cantalouperadio/cantalouperadio/README.md

# Cantaloupe Radio Factory Radio Retrofit Platform

This project contains integrated hardware and firmware to allow stealthy, tight integrations of modern audio technology into factory classic car radios.

TODO lots more to write and explain...
