cantalouperadio/cantalouperadio/hardware/mdeckprogrammer/MDeckProgrammer.brd

## EAGLE design hardware/mdeckprogrammer/MDeckProgrammer.brd (2020-07-01)

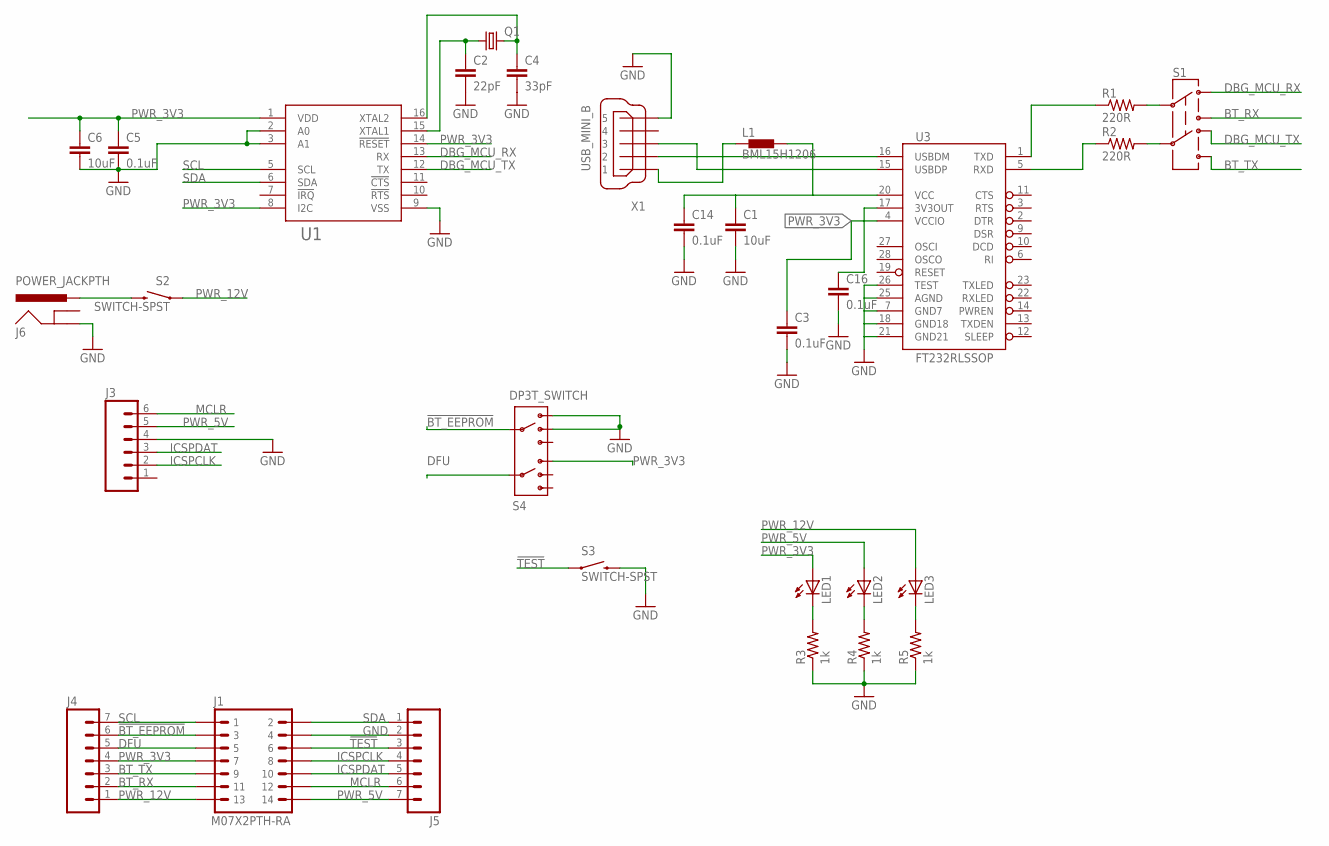
[picture p2: schematic MDeckProgrammer.sch]

Parts:
C1, C6: 10uF; 1206
C2: 22pF; 1206
C3, C5, C14, C16: 0.1uF; 1206
C4: 33pF; 1206
J1: M07X2PTH-RA; JST-14-PUD-PTH
J3: M06HARWIN_RA; 1X06_RA
J4, J5: M07; 1X07
J6: POWER_JACKPTH; POWER_JACK_PTH
L1: BML15H1206; 1206
LED1, LED2, LED3: LEDCHIPLED_1206; CHIPLED_1206
Q1: CRYSTALHC49S; HC49/S
R1, R2: 220R; 1206
R3, R4, R5: 1k; 1206
S1: SWITCH-DPDTPTH; MSS22
S2, S3: SWITCH-SPST; GF-123-0054
S4: DP3T_SWITCH; EG2301A
U1: SC16IS740TSSOP16; TSSOP16
U3: FT232RLSSOP; SSOP28DB
X1: USB_MINI_B; USB_MINI_B_PTH

Connections:
!BT_EEPROM: J1.P$3 (3), J4.6, S4.P$3 (COMA)
!TEST: J1.P$6 (6), J5.3, S3.P$1 (1)
BT_RX: J1.P$11 (11), J4.2, S1.3
BT_TX: J1.P$9 (9), J4.3, S1.6
DBG_MCU_RX: S1.1, U1.13 (RX)
DBG_MCU_TX: S1.4, U1.12 (TX)
DFU: J1.P$5 (5), J4.5, S4.P$7 (COMB)
GND: C1.2, C2.2, C3.2, C4.2, C5.2, C6.2, C14.2, C16.2, J1.P$4 (4), J3.4, J5.2, J6.GND, R3.1, R4.1, R5.1, S3.P$2 (2), S4.P$1 (A1), S4.P$2 (A2), U1.2 (A0), U1.3 (A1), U1.9 (VSS), U3.7 (GND7), U3.18 (GND18), U3.21 (GND21), U3.25 (AGND), U3.26 (TEST), X1.5
ICSPCLK: J1.P$8 (8), J3.2, J5.4
ICSPDAT: J1.P$10 (10), J3.3, J5.5
MCLR: J1.P$12 (12), J3.6, J5.6
unnamed: R1.2, S1.2
unnamed: R2.2, S1.5
unnamed: C2.1, Q1.1, U1.15 (XTAL1)
unnamed: C4.1, Q1.2, U1.16 (XTAL2)
unnamed: J6.PWR, S2.P$2 (2)
unnamed: R1.1, U3.1 (TXD)
unnamed: R2.1, U3.5 (RXD)
unnamed: U3.15 (USBDP), X1.3
unnamed: U3.16 (USBDM), X1.2
unnamed: LED1.C, R3.2
unnamed: L1.1, X1.1
unnamed: C1.1, C14.1, L1.2, U3.20 (VCC)
unnamed: LED2.C, R4.2
unnamed: C16.1, U3.17 (3V3OUT)
unnamed: LED3.C, R5.2
PWR_3V3: C3.1, C5.1, C6.1, J1.P$7 (7), J4.4, LED1.A, S4.P$5 (B1), U1.1 (VDD), U1.8 (I2C), U1.14 (!RESET), U3.4 (VCCIO)
PWR_5V: J1.P$14 (14), J3.5, J5.7, LED2.A
PWR_12V: J1.P$13 (13), J4.1, LED3.A, S2.P$1 (1)
SCL: J1.P$1 (1), J4.7, U1.5 (SCL)
SDA: J1.P$2 (2), J5.1, U1.6 (SDA)

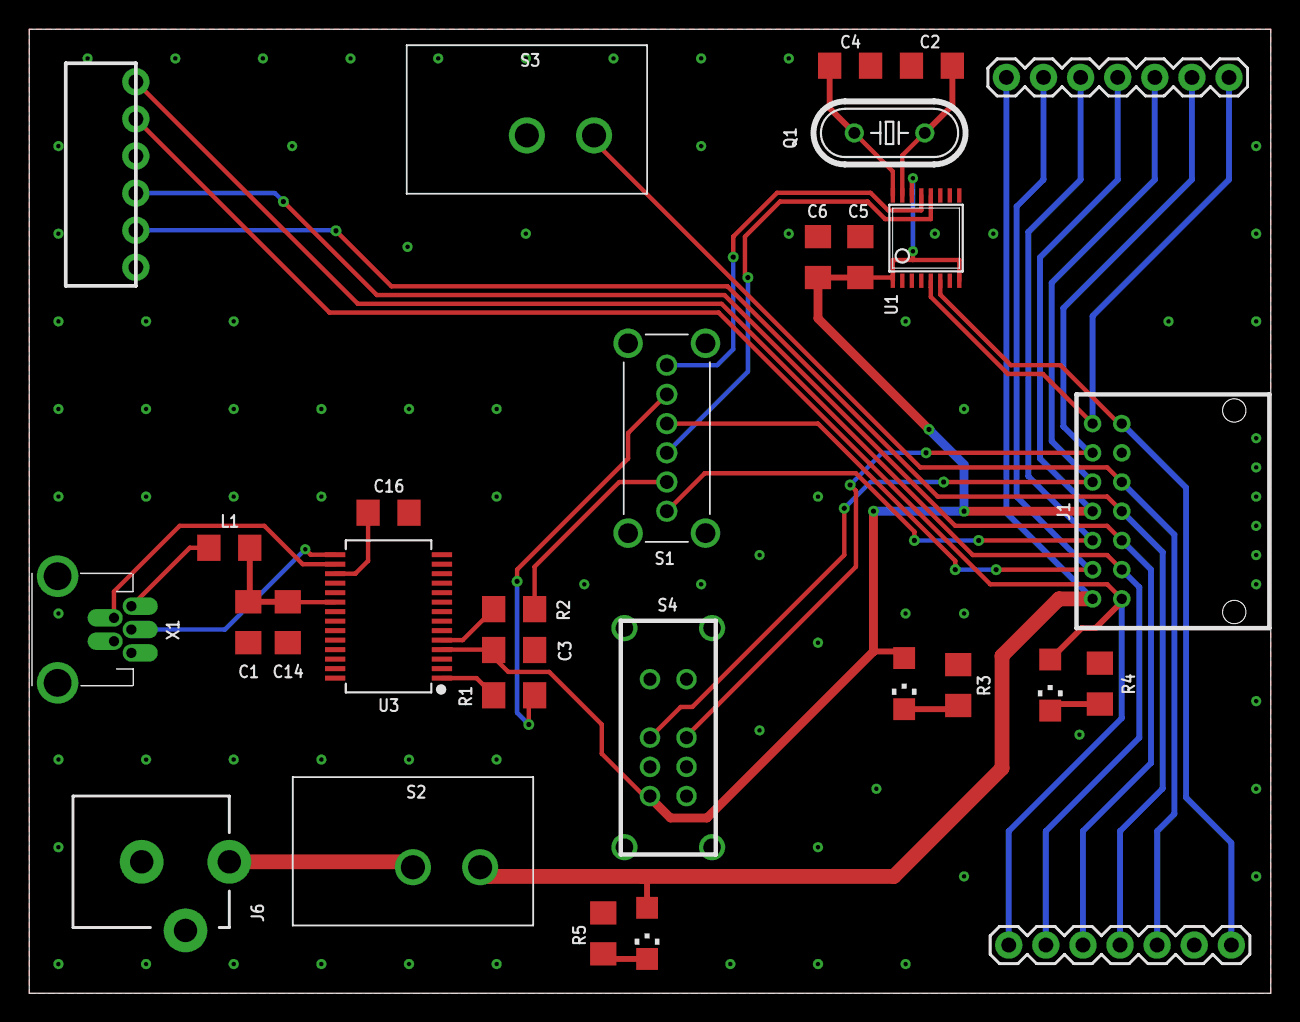
[picture p3: board MDeckProgrammer.brd from above]

Board: 2 copper layers, 85.0 x 66.0 mm, 30 parts (0 on the bottom side), 31 nets.
