cantalouperadio/cantalouperadio/hardware/ba/pogobed/BA2PogoBed.brd

## EAGLE design hardware/ba/pogobed/BA2PogoBed.brd (2020-07-01)

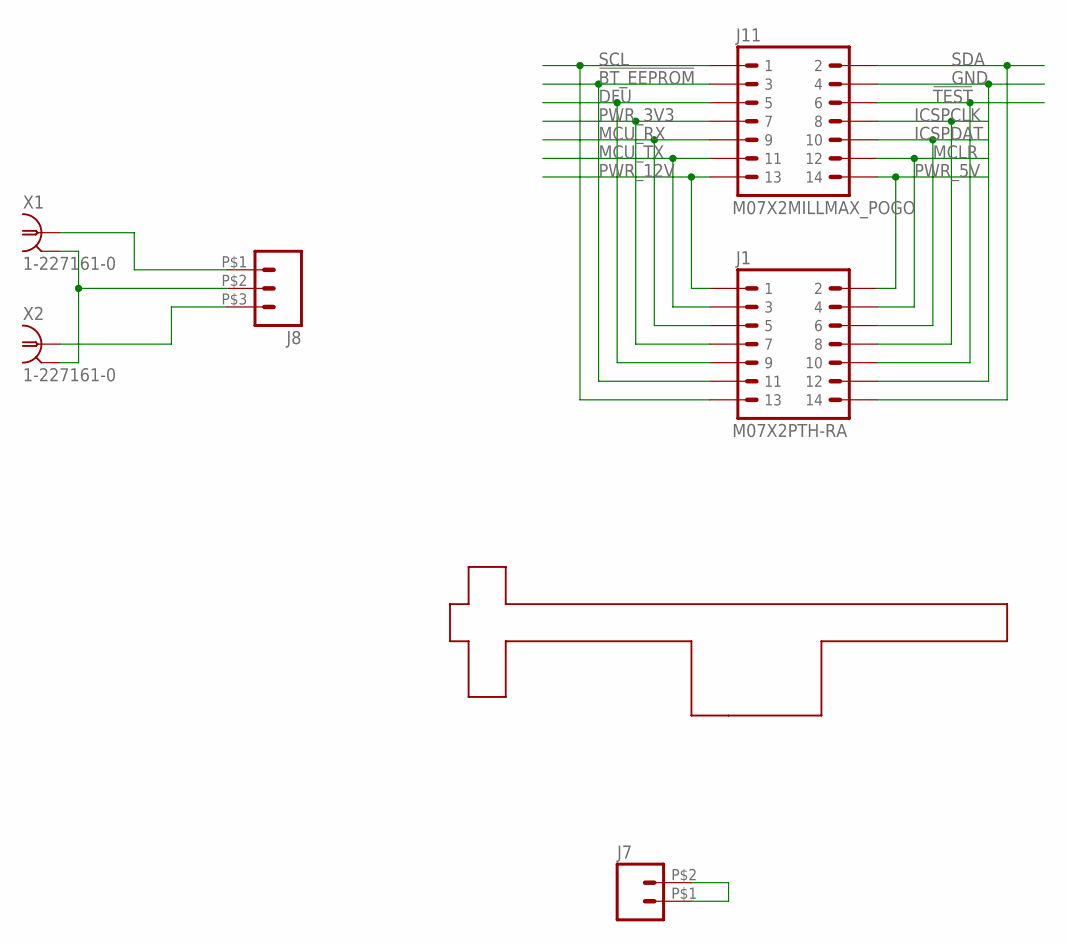
[picture p4: schematic BA2PogoBed.sch, sheet 1]

Parts:
J1: M07X2PTH-RA; JST-14-PUD-PTH
J7: M02; MILLMAX_838_1X2
J8: M03; MILLMAX_836_1X3
J11: M07X2MILLMAX_POGO; MILLMAX_838_7X2
M1: TOGGLE_CLAMP_LARGE
X1, X2: 1-227161-0; AMP_227161

Connections:
!BT_EEPROM: J1.P$11 (11), J11.P$3 (3)
!TEST: J1.P$10 (10), J11.P$6 (6)
DFU: J1.P$9 (9), J11.P$5 (5)
GND: J1.P$12 (12), J11.P$4 (4)
ICSPCLK: J1.P$8 (8), J11.P$8 (8)
ICSPDAT: J1.P$6 (6), J11.P$10 (10)
MCLR: J1.P$4 (4), J11.P$12 (12)
MCU_RX: J1.P$5 (5), J11.P$9 (9)
MCU_TX: J1.P$3 (3), J11.P$11 (11)
unnamed: J7.P$1 (1), J7.P$2 (2)
unnamed: J8.P$2 (2), X1.2, X2.2
unnamed: J8.P$1 (1), X1.1
unnamed: J8.P$3 (3), X2.1
PWR_3V3: J1.P$7 (7), J11.P$7 (7)
PWR_5V: J1.P$2 (2), J11.P$14 (14)
PWR_12V: J1.P$1 (1), J11.P$13 (13)
SCL: J1.P$13 (13), J11.P$1 (1)
SDA: J1.P$14 (14), J11.P$2 (2)

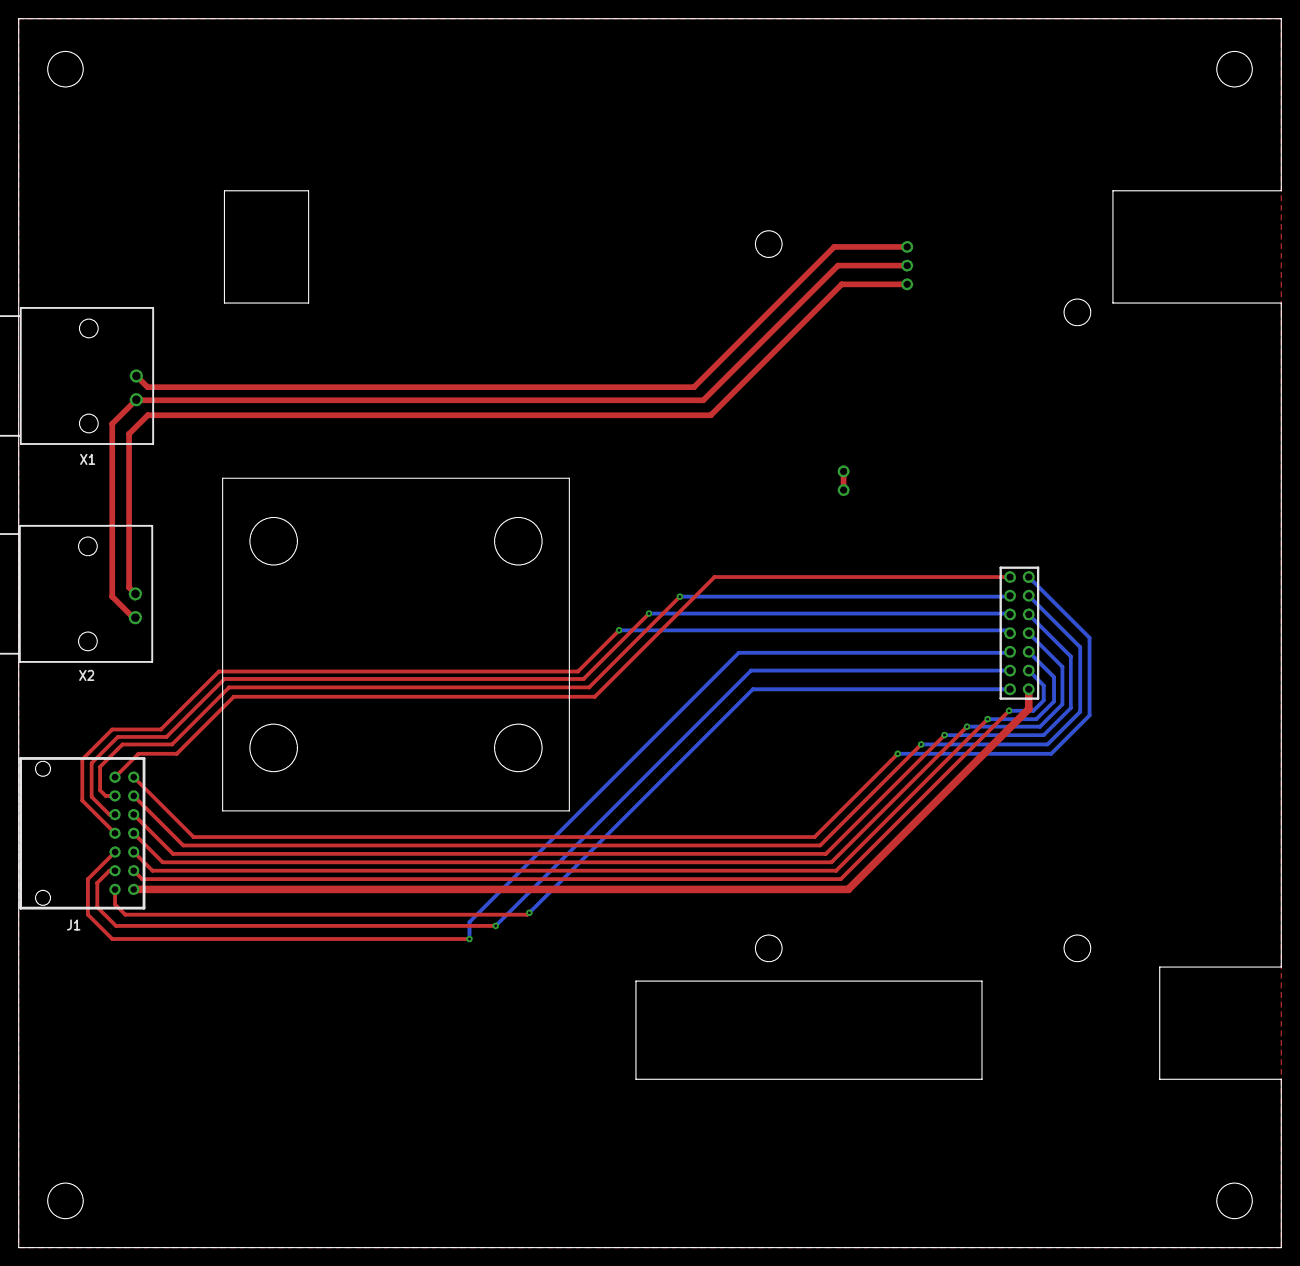
[picture p5: board BA2PogoBed.brd from above]

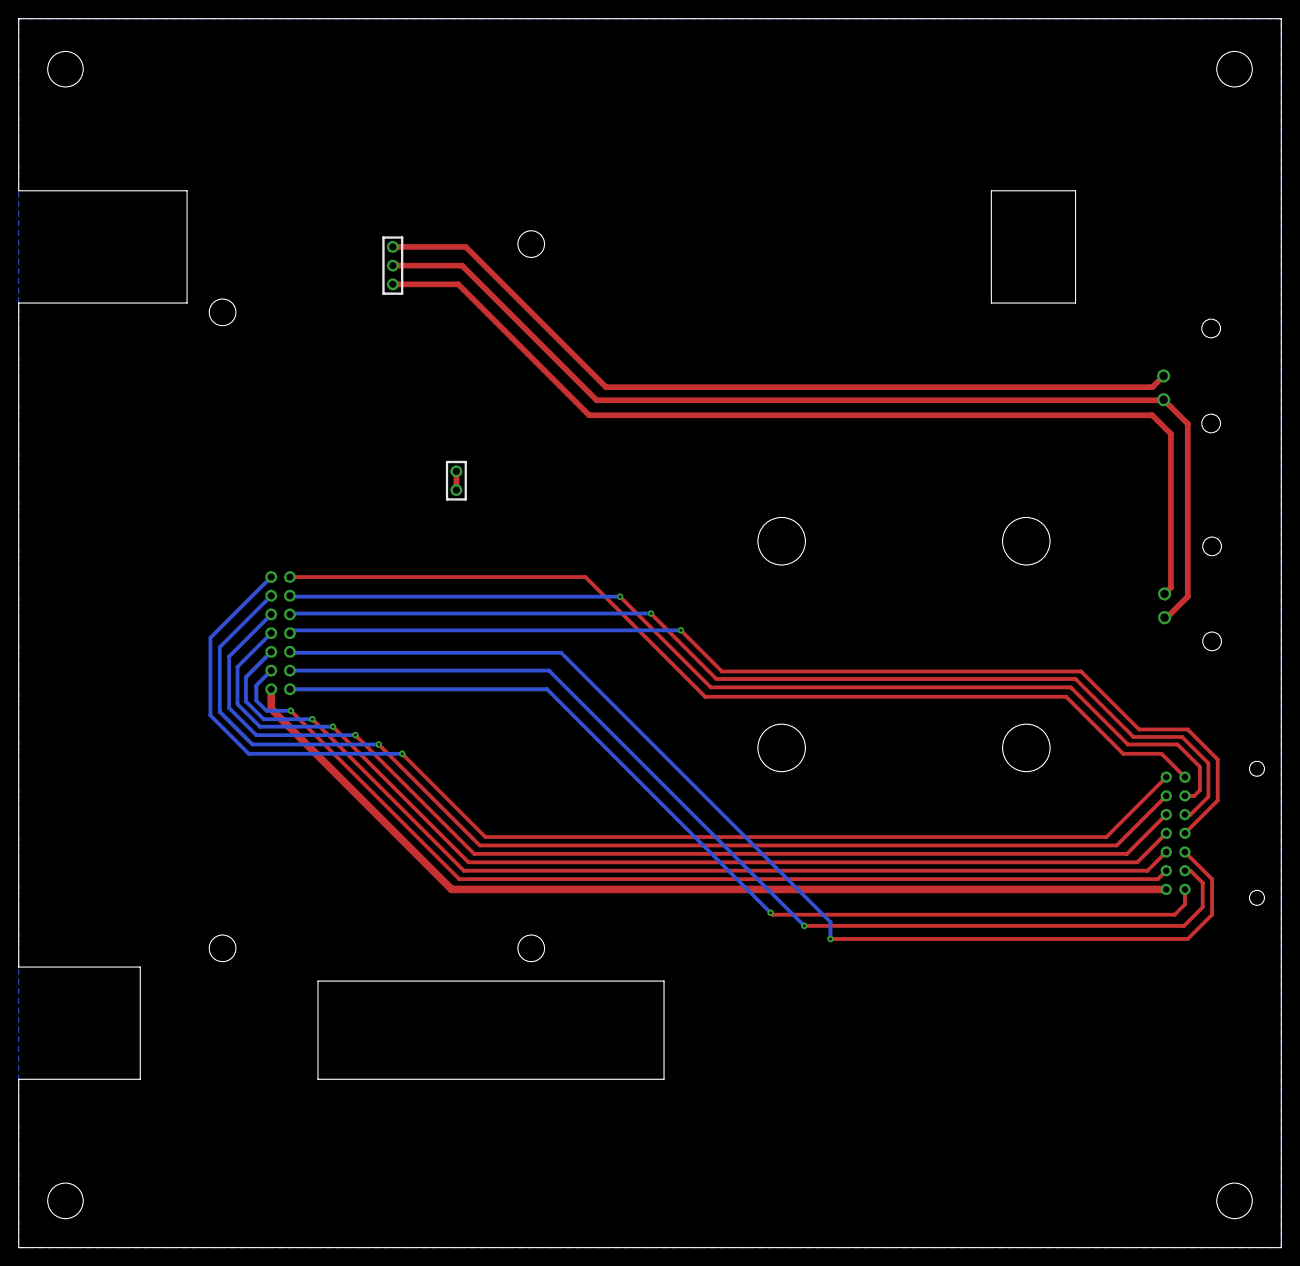
[picture p6: board BA2PogoBed.brd from below]

Board: 2 copper layers, 135.0 x 131.4 mm, 7 parts (2 on the bottom side), 18 nets.
