cantalouperadio/cantalouperadio/hardware/ba/MDeckBA.brd

## EAGLE design hardware/ba/MDeckBA.brd (2020-05-11)

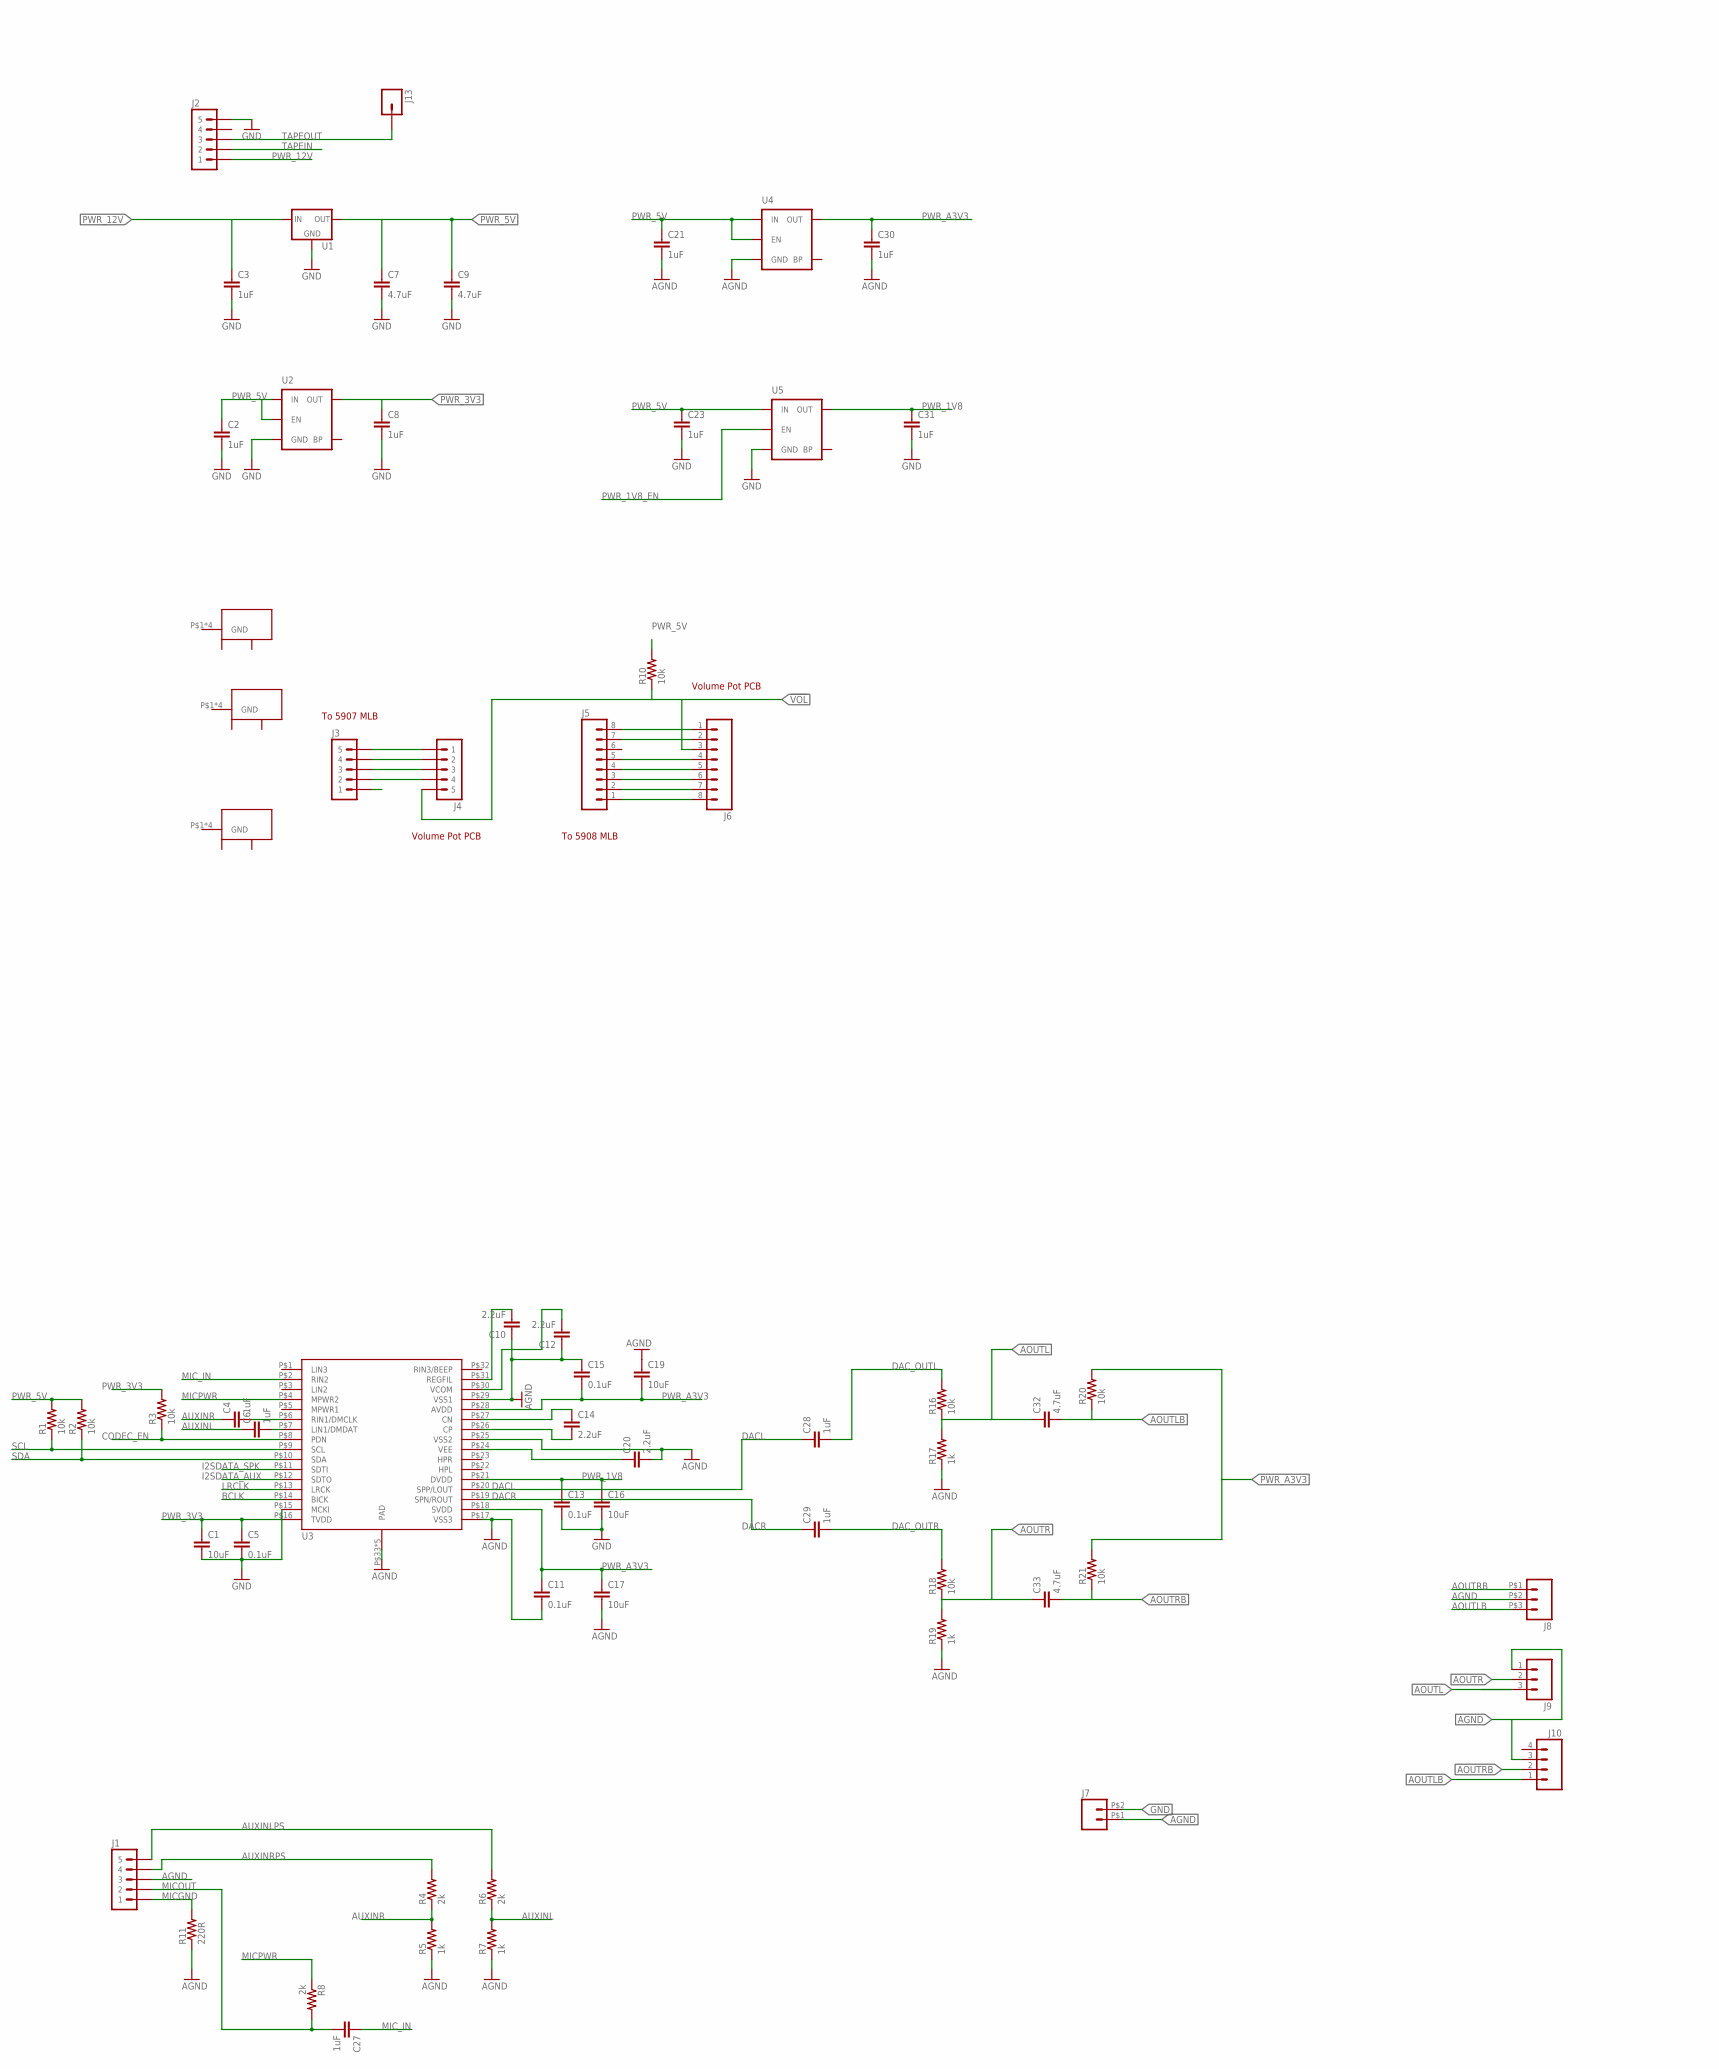
[picture p7: schematic MDeckBA.sch, sheet 1, part in row 1, column 1]

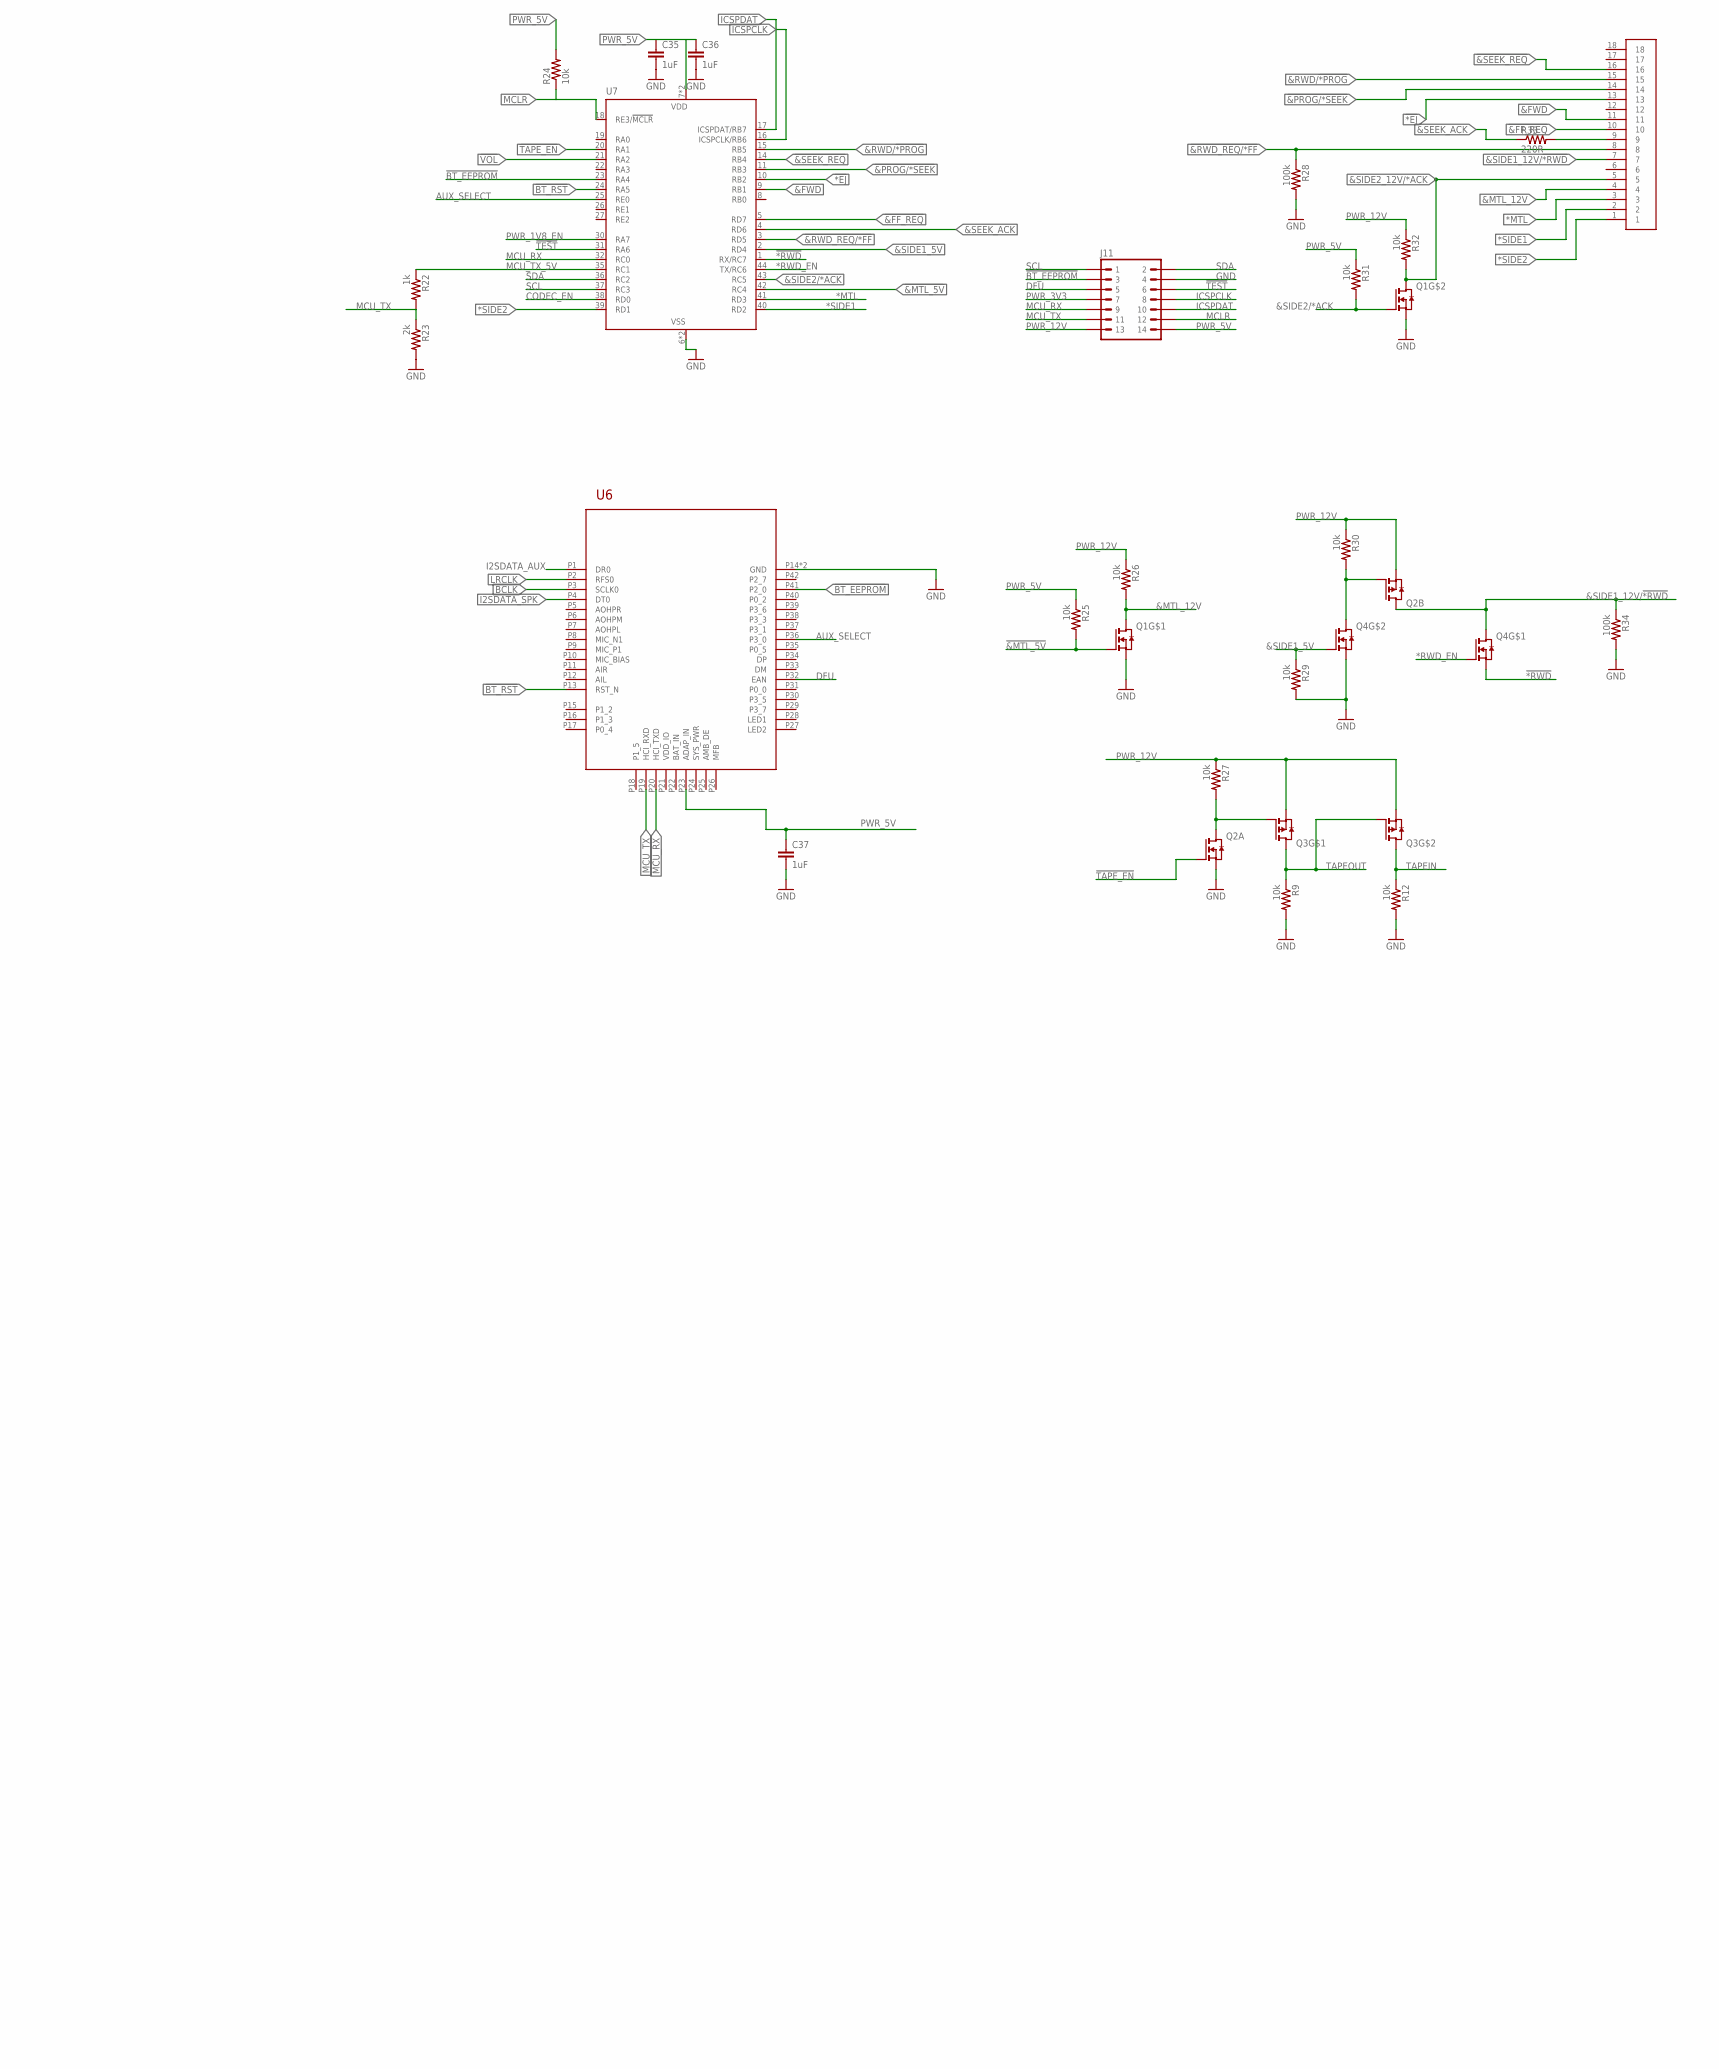
[picture p8: schematic MDeckBA.sch, sheet 1, part in row 1, column 2]

Parts:
C1, C16, C17, C19: 10uF; 0805
C2, C3, C4, C6, C8, C21, C23, C27, C28, C29, C30, C31, C35, C36, C37: 1uF; 0805
C5, C11, C13, C15: 0.1uF; 0805
C7, C9, C32, C33: 4.7uF; 0805
C10, C12, C14, C20: 2.2uF; 0805
J1, J3: M05JST; JST-5-PTH
J2, J4: M05JST-VERT; JST-5-PTH-VERT
J5: JST-PH-8; JST-8-PTH
J6: JST-PH-8-VERT; JST-8-PTH-VERT
J7: M022MM_PADS; 1X02_2MM_PADS
J8: M032MM_PADS; 1X03_2MM_PADS
J9: M03JST-PTH-VERT; JST-3-PTH-VERT
J10: M04JST-PTH-VERT; JST-4-PTH-VERT
J11: M07X2; 2X07_PADS_2MM
J12: MOLEX_0039532184_18_POS_FFC
J13: M01PTH_NO_SILK_YES_STOP; 1X01_NO_SILK
M1, M2, M3: KEYSTONE_7773_SCREW_TERMINAL
Q1, Q4: N_MOSFETSOT-363; SOT363
Q2: PN_MOSFET-FDG6332C_F085SOT363; SOT363
Q3: P_MOSFET_DUAL; SO08
R1, R2, R3, R9, R10, R12, R16, R18, R20, R21, R24, R25, R26, R27, R29, R30, R31, R32: 10k; 0805
R4, R6, R8, R23: 2k; 0805
R5, R7, R17, R19, R22: 1k; 0805
R11: 220R; 2010-RES
R28, R34: 100k; 0805
R33: 220R; 0805
U1: V_REG_SOT223LDL1117; SOT223
U2: V_REG_LDOMIC5317SMD; SOT23-5
U3: AK4951; QFN32_0.4MM
U4: V_REG_LDOLDLN025SMD; SOT23-5
U5: V_REG_LDOMIC5317-1.8SMD; SOT23-5
U6: BM64SMD; BM64
U7: PIC16LF18875PIC16LF18877; TQFP44

Connections:
!&FF_REQ: J12.10, U7.5 (RD7)
!&MTL_5V: Q1.2 (G), R25.2, U7.42 (RC4)
!&PROG/*SEEK: J12.14, U7.11 (RB3)
!&RWD_REQ/*FF: J12.8, R28.1, U7.3 (RD5)
!&SEEK_REQ: J12.16, U7.14 (RB4)
!*EJ: J12.13, U7.10 (RB2)
!*RWD: Q4.1 (S), U7.1 (RX/RC7)
!BT_EEPROM: J11.P$3 (3), U6.P41 (P2_0), U7.23 (RA4)
!BT_RST: U6.P13 (RST_N), U7.24 (RA5)
!TAPE_EN: Q2.2 (G), U7.20 (RA1)
!TEST: J11.P$6 (6), U7.31 (RA6)
!VOL: J4.5, J6.3, R10.1, U7.21 (RA2)
&FWD: J12.11, U7.9 (RB1)
&MTL_12V: J12.4, Q1.6 (D), R26.2
&RWD/!*PROG: J12.15, U7.15 (RB5)
&SEEK_ACK: R33.1, U7.4 (RD6)
&SIDE1_5V: Q4.5 (G), R29.1, U7.2 (RD4)
&SIDE1_12V/!*RWD: J12.7, Q2.3 (D), Q4.6 (D), R34.1
&SIDE2/*ACK: Q1.5 (G), R31.2, U7.43 (RC5)
&SIDE2_12V/*ACK: J12.5, Q1.3 (D), R32.2
*MTL: J12.3, U7.41 (RD3)
*RWD_EN: Q4.2 (G), U7.44 (TX/RC6)
*SIDE1: J12.2, U7.40 (RD2)
*SIDE2: J12.1, U7.39 (RD1)
AGND: C10.1, C11.2, C12.1, C15.1, C17.2, C19.1, C20.2, C21.2, C30.2, J1.3, J7.P$1 (1), J8.P$2 (2), J9.1, J10.3, R5.1, R7.1, R11.1, R17.1, R19.1, U3.P$17 (VSS3), U3.P$25 (VSS2), U3.P$29 (VSS1), U3.P$33 (PAD), U3.P$34 (PAD), U3.P$35 (PAD), U3.P$36 (PAD), U3.P$37 (PAD), U4.2 (GND)
AOUTL: C32.1, J9.3, R16.1, R17.2
AOUTLB: C32.2, J8.P$3 (3), J10.1, R20.1
AOUTR: C33.1, J9.2, R18.1, R19.2
AOUTRB: C33.2, J8.P$1 (1), J10.2, R21.1
AUXINL: C6.1, R6.1, R7.2
AUXINLPS: J1.5, R6.2
AUXINR: C4.1, R4.1, R5.2
AUXINRPS: J1.4, R4.2
AUX_SELECT: U6.P36 (P3_0), U7.25 (RE0)
BCLK: U3.P$14 (BICK), U6.P3 (SCLK0)
CODEC_EN: R3.1, U3.P$8 (PDN), U7.38 (RD0)
DACL: C28.1, U3.P$20 (SPP/LOUT)
DACR: C29.1, U3.P$19 (SPN/ROUT)
DAC_OUTL: C28.2, R16.2
DAC_OUTR: C29.2, R18.2
DFU: J11.P$5 (5), U6.P32 (EAN)
GND: C1.2, C2.2, C3.2, C5.2, C7.2, C8.2, C9.2, C13.2, C16.2, C23.2, C31.2, C35.2, C36.2, C37.2, J2.5, J7.P$2 (2), J11.P$4 (4), Q1.1 (S), Q1.4 (S), Q2.1 (S), Q4.4 (S), R9.2, R12.2, R23.2, R28.2, R29.2, R34.2, U1.1 (GND), U2.2 (GND), U3.P$15 (MCKI), U5.2 (GND), U6.P14 (GND), U6.P43 (GND), U7.6 (VSS), U7.29 (VSS)
I2SDATA_AUX: U3.P$12 (SDTO), U6.P1 (DR0)
I2SDATA_SPK: U3.P$11 (SDTI), U6.P4 (DT0)
ICSPCLK: J11.P$8 (8), U7.16 (ICSPCLK/RB6)
ICSPDAT: J11.P$10 (10), U7.17 (ICSPDAT/RB7)
LRCLK: U3.P$13 (LRCK), U6.P2 (RFS0)
MCLR: J11.P$12 (12), R24.1, U7.18 (RE3/!MCLR)
MCU_RX: J11.P$9 (9), U6.P20 (HCI_TXD), U7.32 (RC0)
MCU_TX: J11.P$11 (11), R22.2, R23.1, U6.P19 (HCI_RXD)
MCU_TX_5V: R22.1, U7.35 (RC1)
MICGND: J1.1, R11.2
MICOUT: C27.2, J1.2, R8.2
MICPWR: R8.1, U3.P$4 (MPWR2)
MIC_IN: C27.1, U3.P$2 (RIN2)
unnamed: J12.9, R33.2
unnamed: Q2.5 (G), Q4.3 (D), R30.2
unnamed: C14.2, U3.P$26 (CP)
unnamed: C10.2, U3.P$31 (REGFIL)
unnamed: C20.1, U3.P$24 (VEE)
unnamed: J5.8, J6.1
unnamed: C12.2, U3.P$30 (VCOM)
unnamed: C14.1, U3.P$27 (CN)
unnamed: C6.2, U3.P$7 (LIN1/DMDAT)
unnamed: J5.7, J6.2
unnamed: J5.5, J6.4
unnamed: J5.4, J6.5
unnamed: J5.3, J6.6
unnamed: J5.2, J6.7
unnamed: J5.1, J6.8
unnamed: C4.2, U3.P$6 (RIN1/DMCLK)
unnamed: J3.5, J4.1
unnamed: J3.4, J4.2
unnamed: J3.3, J4.3
unnamed: J3.2, J4.4
PWR_1V8: C13.1, C16.1, C31.1, U3.P$21 (DVDD), U5.5 (OUT)
PWR_1V8_EN: U5.3 (EN), U7.30 (RA7)
PWR_3V3: C1.1, C5.1, C8.1, J11.P$7 (7), R3.2, U2.5 (OUT), U3.P$16 (TVDD)
PWR_5V: C2.1, C7.1, C9.1, C21.1, C23.1, C35.1, C36.1, C37.1, J11.P$14 (14), R1.2, R2.2, R10.2, R24.2, R25.1, R31.1, U1.2 (OUT), U1.4 (OUT), U2.1 (IN), U2.3 (EN), U4.1 (IN), U4.3 (EN), U5.1 (IN), U6.P23 (ADAP_IN), U7.7 (VDD), U7.28 (VDD)
PWR_12V: C3.1, J2.1, J11.P$13 (13), Q2.4 (S), Q3.1 (S), Q3.3 (S), R26.1, R27.1, R30.1, R32.1, U1.3 (IN)
PWR_A3V3: C11.1, C15.2, C17.1, C19.2, C30.1, R20.2, R21.2, U3.P$18 (SVDD), U3.P$28 (AVDD), U4.5 (OUT)
SCL: J11.P$1 (1), R1.1, U3.P$9 (SCL), U7.37 (RC3)
SDA: J11.P$2 (2), R2.1, U3.P$10 (SDA), U7.36 (RC2)
TAPEIN: J2.2, Q3.5 (D), Q3.6 (D), R12.1
TAPEINSIG: Q2.6 (D), Q3.2 (G), R27.2
TAPEOUT: J2.3, J13.1, Q3.4 (G), Q3.7 (D), Q3.8 (D), R9.1

Notes on the sheet:
Volume Pot PCB
To 5908 MLB
To 5907 MLB

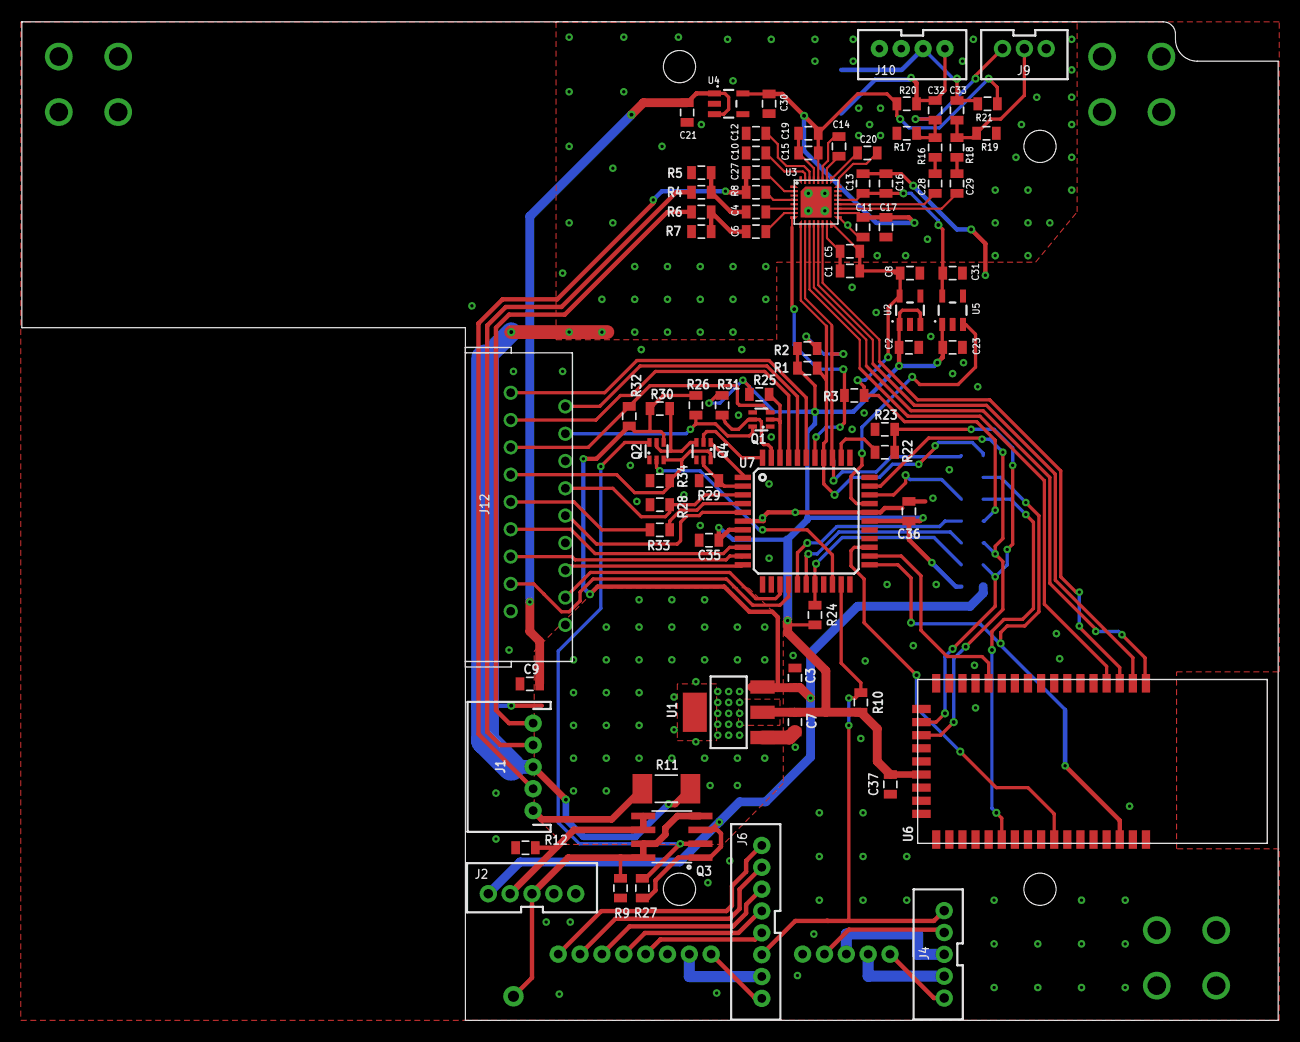
[picture p9: board MDeckBA.brd from above]

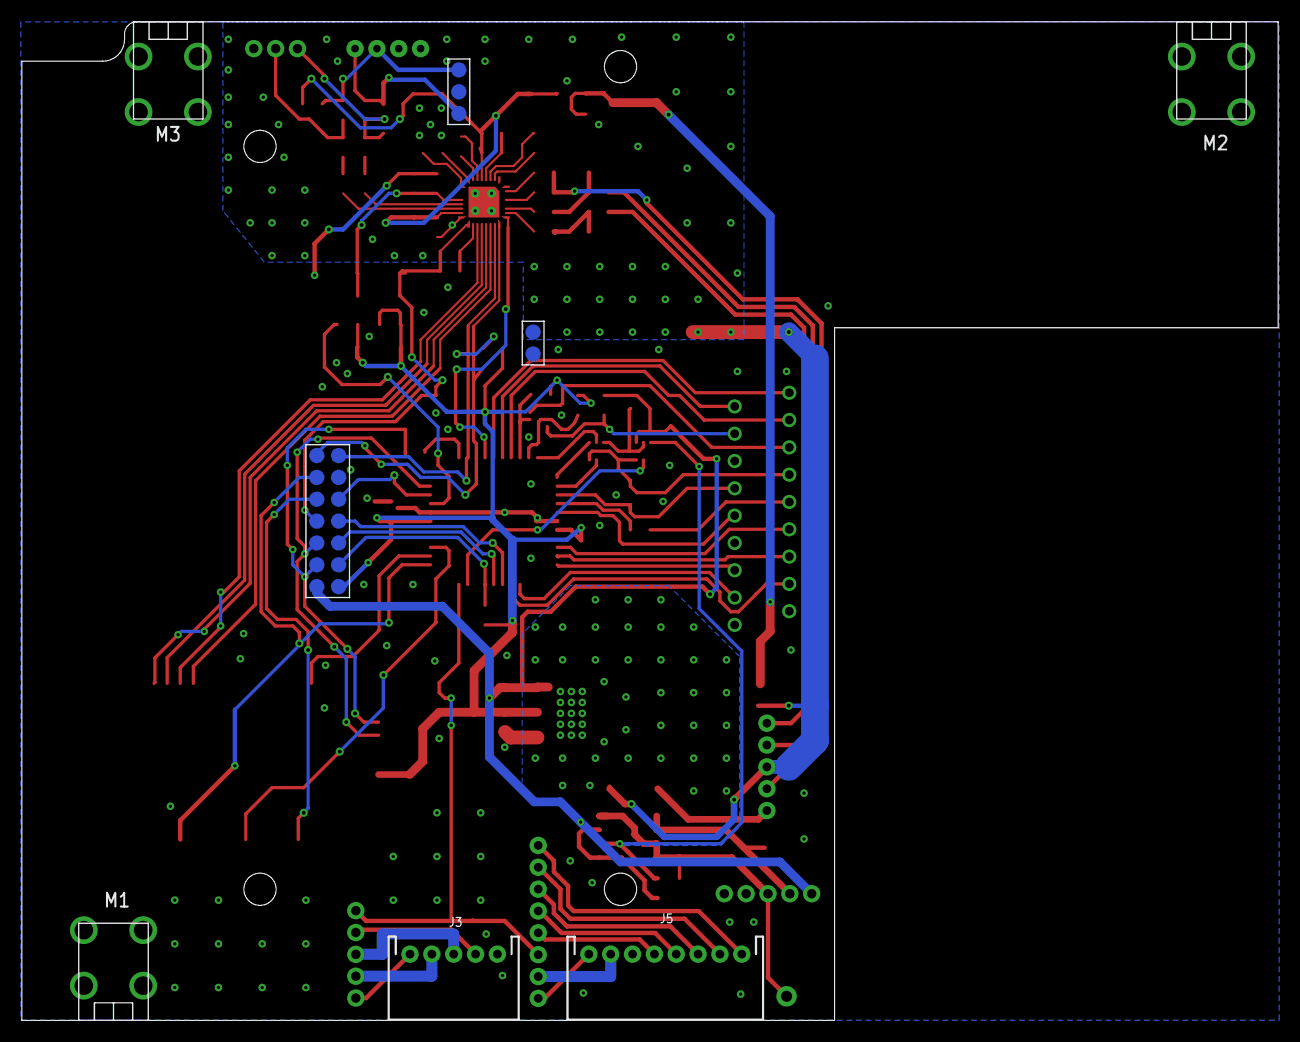
[picture p10: board MDeckBA.brd from below]

Board: 2 copper layers, 115.0 x 91.4 mm, 89 parts (7 on the bottom side), 86 nets.
