cantalouperadio/cantalouperadio/(commit log)

2020-05-11 Initial commit of gitignore, license, and eagle cad, gerbers, and bm64 config for ba-2 rev9
    [MDeckBA.brd, MDeckBA.sch, MDeckBA2_rev9_BOM.csv]
2020-05-11 Actually add gerbers
2020-07-01 Adding BA-2 aux board BOMs and more work on readme
    [BOM.csv]
2020-07-01 Adding eagle files for BA2 aux boards
    [BA2PogoBed.brd, BA2PogoBed.sch, MDeckProgrammer.brd, MDeckProgrammer.sch, ToggleClampSpacer.brd, ToggleClampSpacer.sch]
