cantalouperadio/cantalouperadio/(notices)

Notices in the files:
hardware/mdeckprogrammer/MDeckProgrammer.brd:
Copyright 2018 Cantaloupe Radio LLC
parts and their libraries:
SparkFun-Aesthetics: Licensing: Creative Commons ShareAlike 4.0 International - https://creativecommons.org/licenses/by-sa/4.0
